IRNAS/PreciseXY/Photos/precisexy-v2-back.jpg

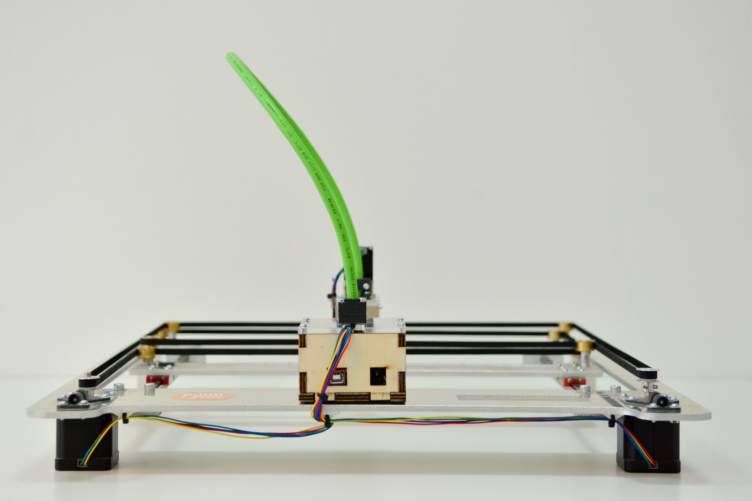
Photos/precisexy-v2-back.jpg
