IRNAS/PreciseXY/Photos/precisexy-v2-front.jpg

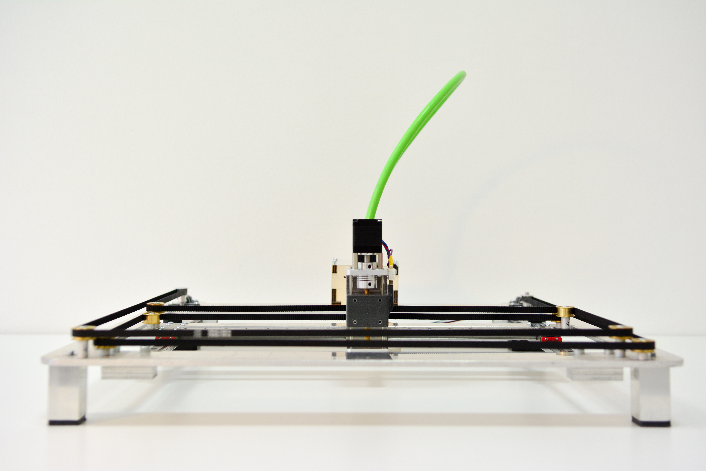
Photos/precisexy-v2-front.jpg
