IRNAS/PreciseXY/Photos/precisexy-v2-zaxis.jpg

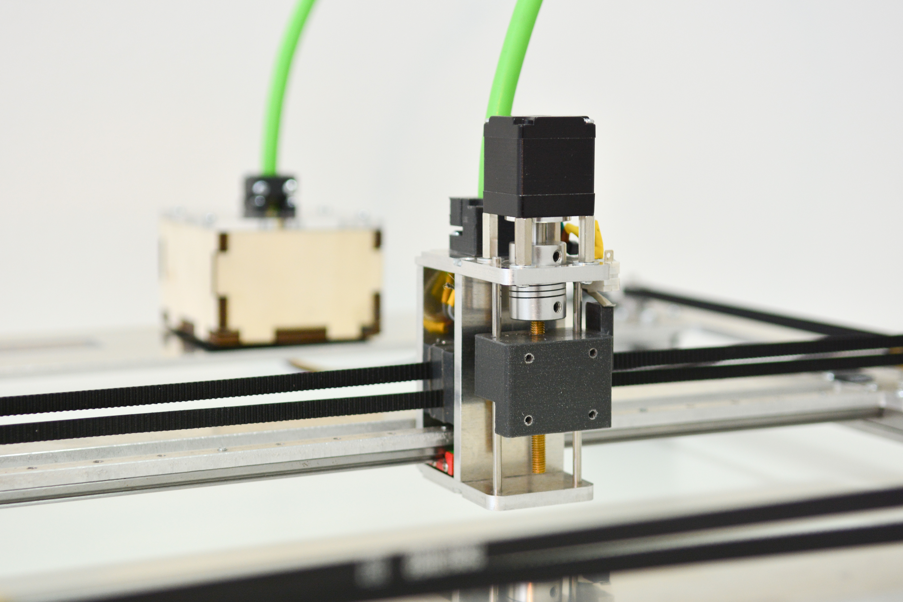
Photos/precisexy-v2-zaxis.jpg
