IRNAS/PreciseXY/Photos/precisexy-v2.jpg

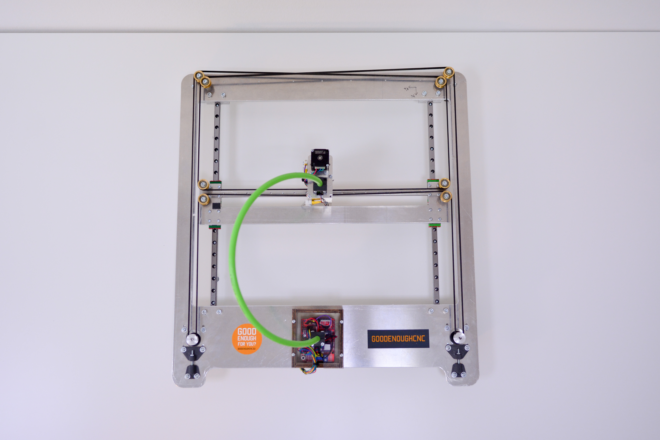
Photos/precisexy-v2.jpg
