IRNAS/PreciseXY/DXF/Assem - BOM.DXF

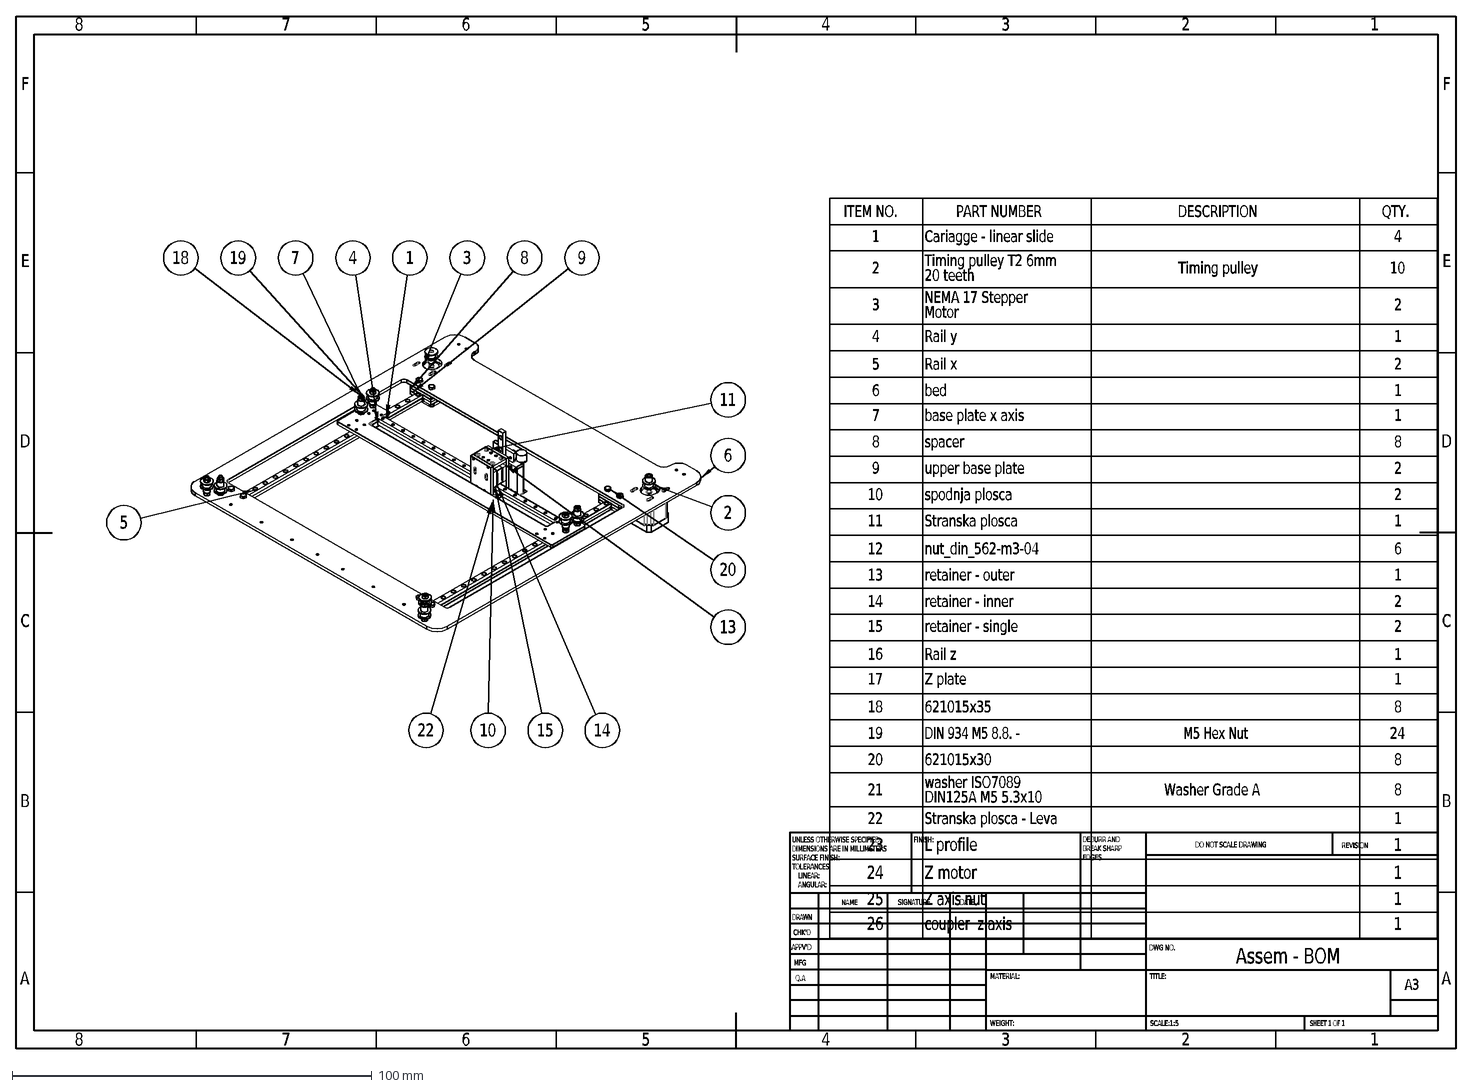
[picture p7: CAD file, 2015-09-21, last stored version]
DXF/Assem - BOM.DXF
8
7
A
B
2
3
4
5
6
1
E
D
C
F
DRAWN
CHK'D
APPV'D
MFG
Q.A
UNLESS OTHERWISE SPECIFIED:
DIMENSIONS ARE IN MILLIMETERS
SURFACE FINISH:
TOLERANCES:
LINEAR:
ANGULAR:
FINISH:
DEBURR AND
BREAK SHARP
EDGES
NAME
SIGNATURE
DATE
MATERIAL:
DO NOT SCALE DRAWING
REVISION
TITLE:
DWG NO.
SCALE:1:5
SHEET 1 OF 1
A3
WEIGHT:
Assem - BOM
ITEM NO.
PART NUMBER
DESCRIPTION
QTY.
Cariagge - linear slide
Timing pulley T2 6mm
20 teeth
Timing pulley
10
NEMA 17 Stepper
Motor
Rail y
Rail x
bed
base plate x axis
spacer
9
upper base plate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
