IRNAS/PreciseXY/Step/L profile.STEP

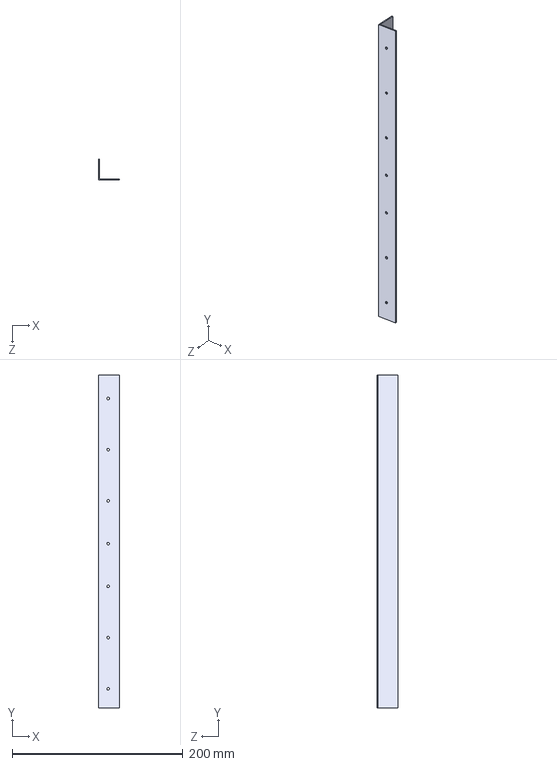
[picture p8: CAD file, 2015-09-21, last stored version]
Step/L profile.STEP
25.0 x 390.0 x 25.0 mm
