IRNAS/PreciseXY/Step/spodnja plosca.STEP

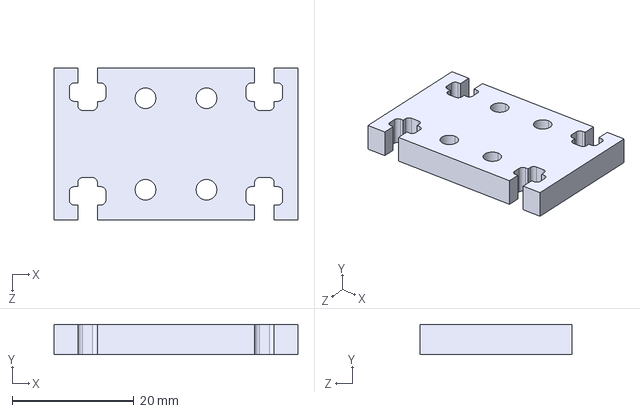
[picture p9: CAD file, 2015-09-21, last stored version]
Step/spodnja plosca.STEP
40.0 x 5.00 x 25.0 mm
