IRNAS/PreciseXY/Step/Timing pulley T2 6mm 20 teeth.STEP

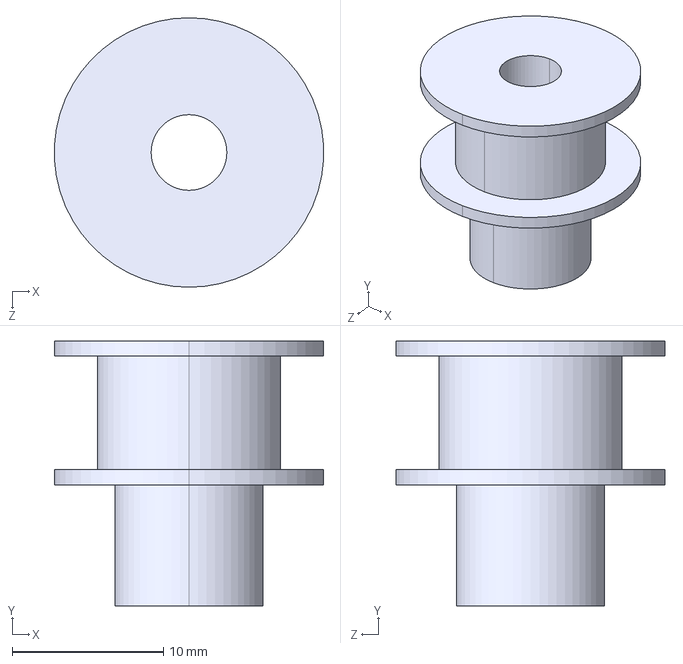
[picture p10: CAD file, 2015-09-21, last stored version]
Step/Timing pulley T2 6mm 20 teeth.STEP
17.8 x 17.5 x 17.8 mm
