IRNAS/PreciseXY/Step/base plate x axis.STEP

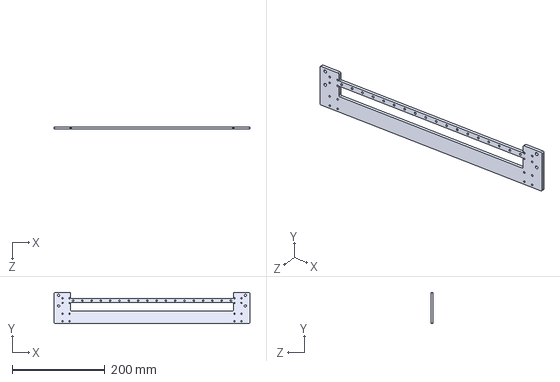
[picture p11: CAD file, 2015-09-21, last stored version]
Step/base plate x axis.STEP
422.0 x 66.8 x 5.00 mm
