IRNAS/PreciseXY/Step/Z plate.STEP

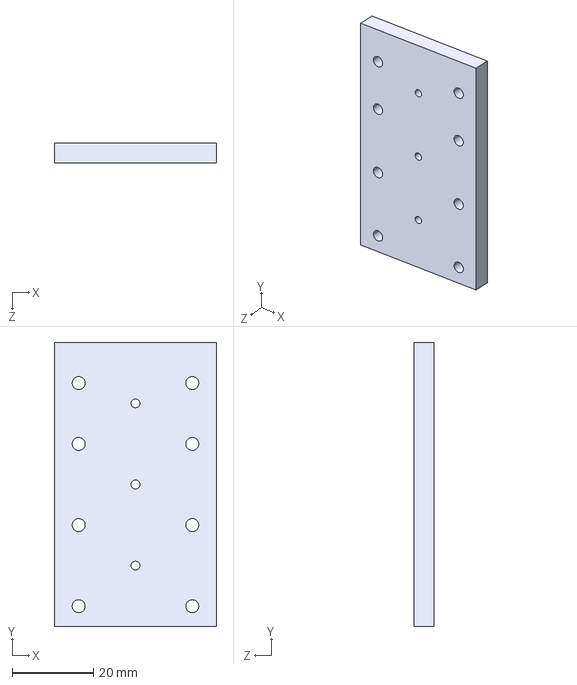
[picture p12: CAD file, 2015-09-21, last stored version]
Step/Z plate.STEP
40.0 x 70.0 x 5.00 mm
