IRNAS/PreciseXY/Step/coupler  z axis.STEP

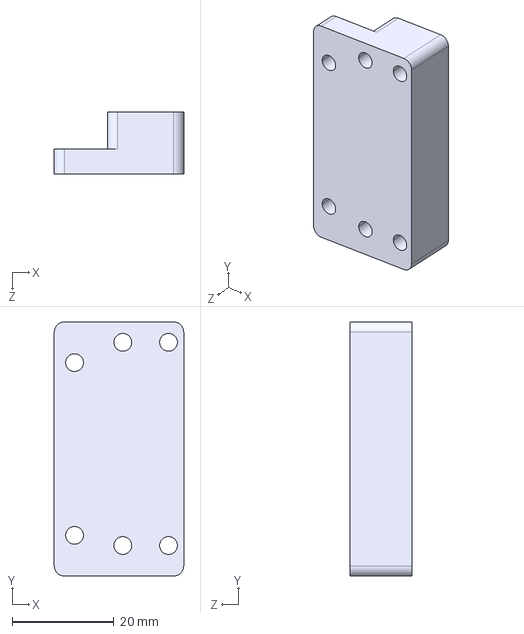
[picture p13: CAD file, 2015-09-21, last stored version]
Step/coupler z axis.STEP
25.5 x 50.0 x 12.3 mm
