IRNAS/PreciseXY/Step/Rail y.STEP

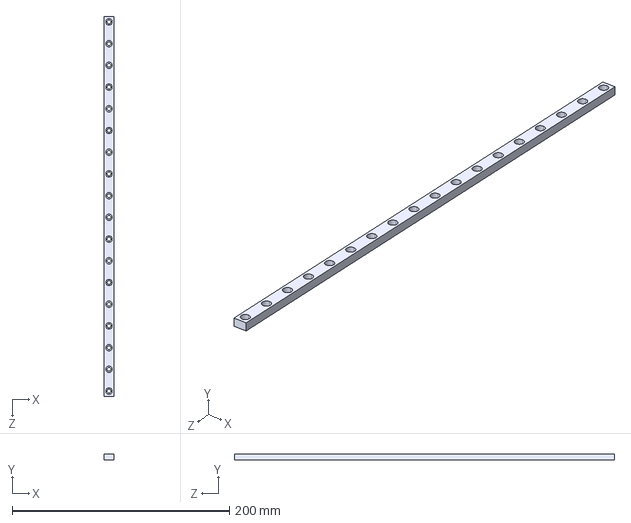
[picture p14: CAD file, 2015-09-21, last stored version]
Step/Rail y.STEP
9.00 x 5.50 x 350.0 mm
