IRNAS/PreciseXY/Step/Stranska plosca.STEP

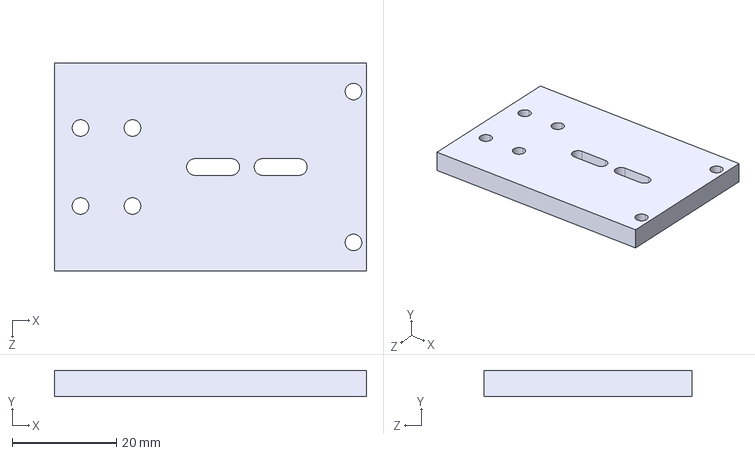
[picture p15: CAD file, 2015-09-21, last stored version]
Step/Stranska plosca.STEP
60.0 x 5.00 x 40.0 mm
