IRNAS/PreciseXY/Step/NEMA 17 Stepper Motor.STEP

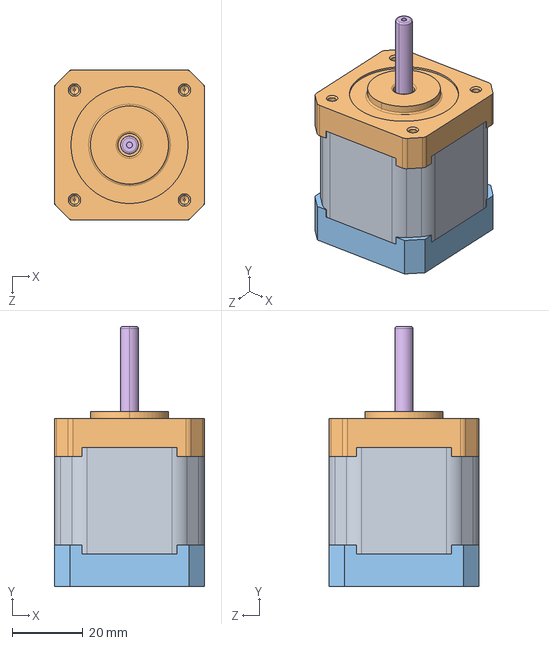
[picture p16: CAD file, 2015-09-21, last stored version]
Step/NEMA 17 Stepper Motor.STEP
42.3 x 73.3 x 42.3 mm
