IRNAS/PreciseXY/Step/retainer - outer.STEP

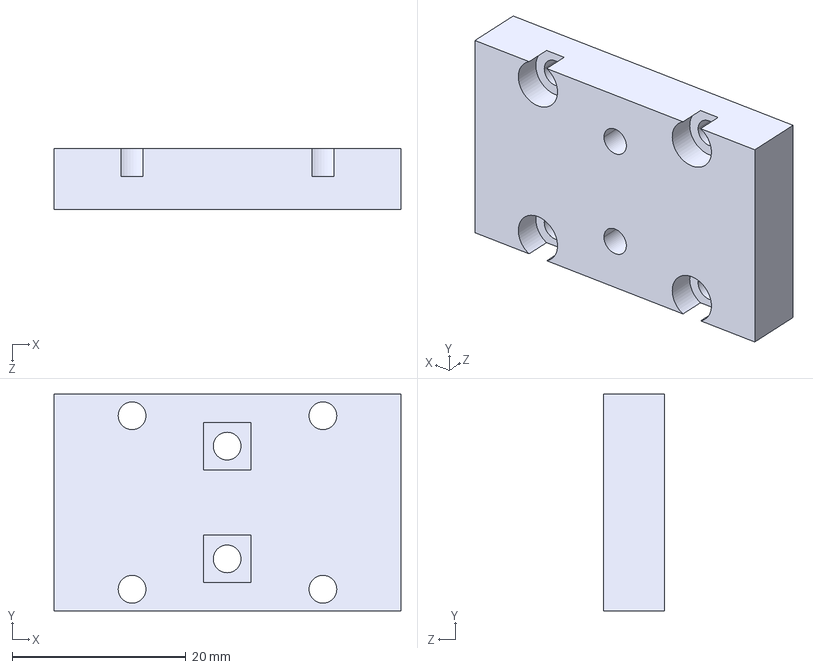
[picture p17: CAD file, 2015-09-21, last stored version]
Step/retainer - outer.STEP
40.0 x 25.0 x 7.00 mm
