IRNAS/PreciseXY/Step/retainer - single.STEP

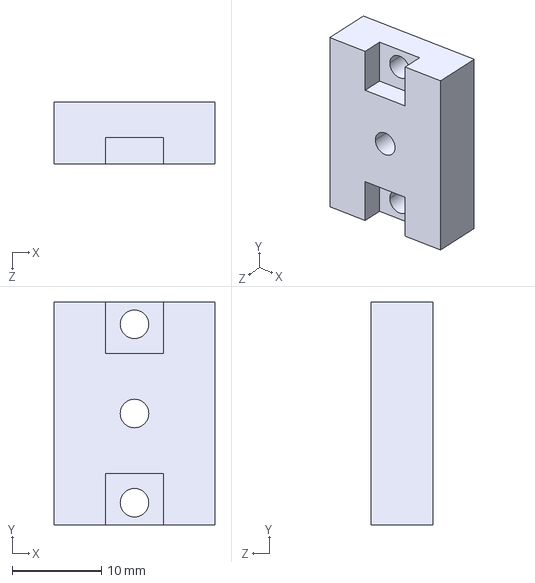
[picture p18: CAD file, 2015-09-21, last stored version]
Step/retainer - single.STEP
18.0 x 25.0 x 7.00 mm
