IRNAS/PreciseXY/Step/spacer.STEP

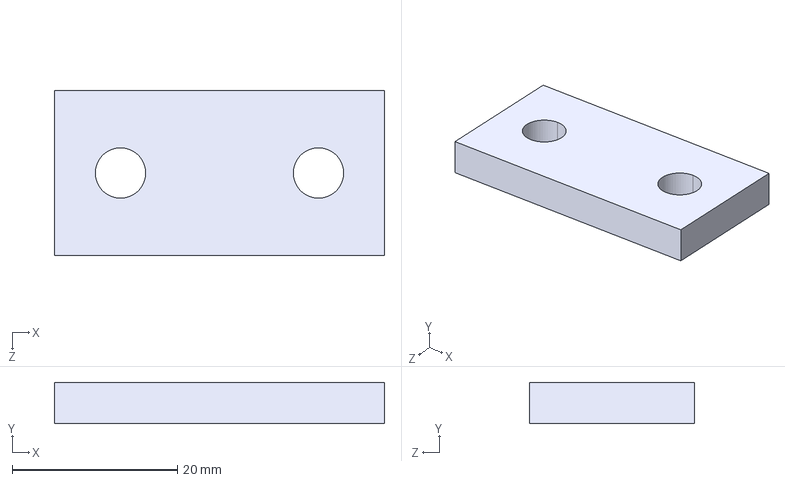
[picture p19: CAD file, 2015-09-21, last stored version]
Step/spacer.STEP
40.0 x 5.00 x 20.0 mm
