IRNAS/PreciseXY/Step/bed.STEP

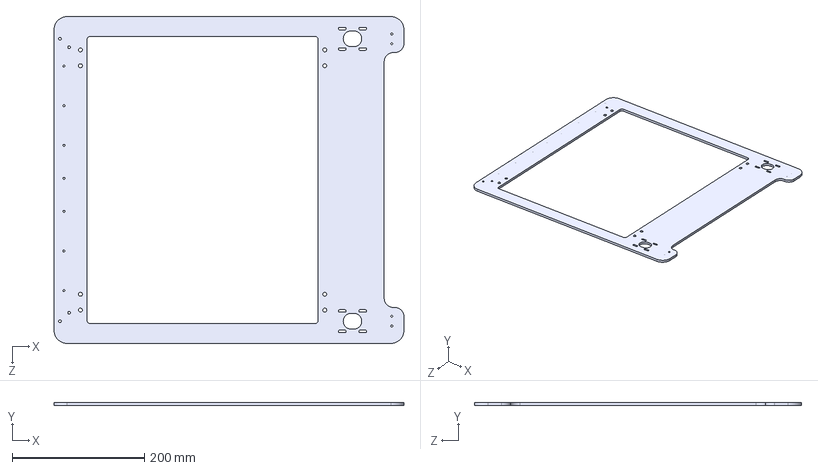
[picture p20: CAD file, 2015-09-21, last stored version]
Step/bed.STEP
530.0 x 5.00 x 495.0 mm
