IRNAS/PreciseXY/Step/upper base plate.STEP

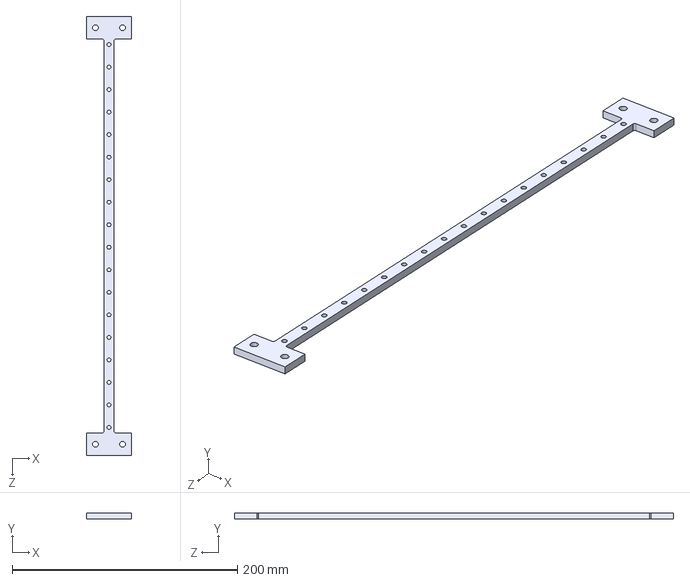
[picture p21: CAD file, 2015-09-21, last stored version]
Step/upper base plate.STEP
40.0 x 5.00 x 390.0 mm
