IRNAS/PreciseXY/Step/retainer - inner.STEP

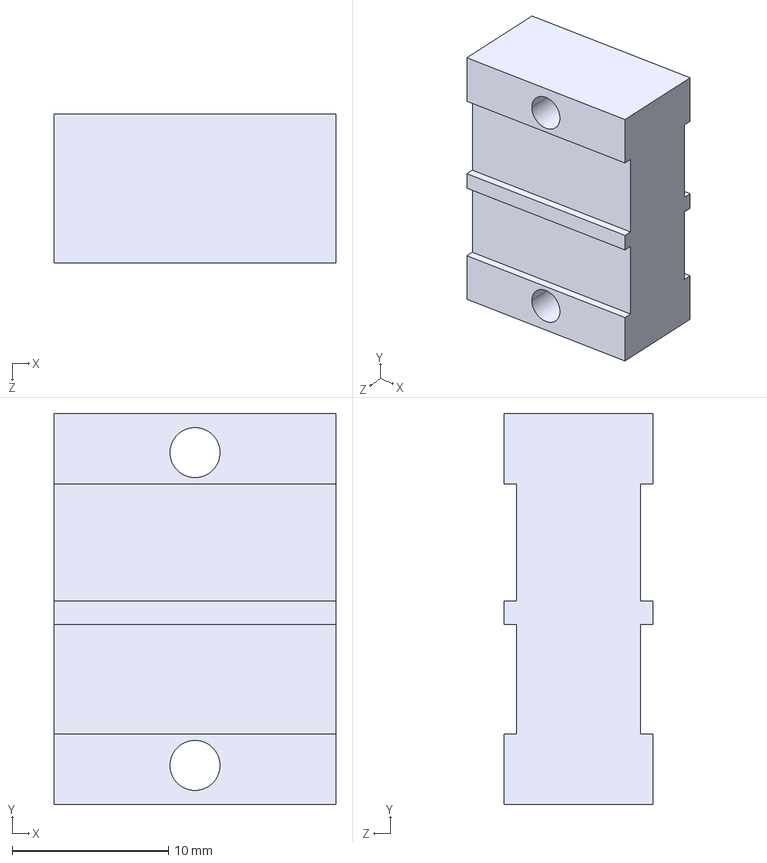
[picture p22: CAD file, 2015-09-21, last stored version]
Step/retainer - inner.STEP
18.0 x 25.0 x 9.50 mm
