IRNAS/PreciseXY/Step/Z motor.STEP

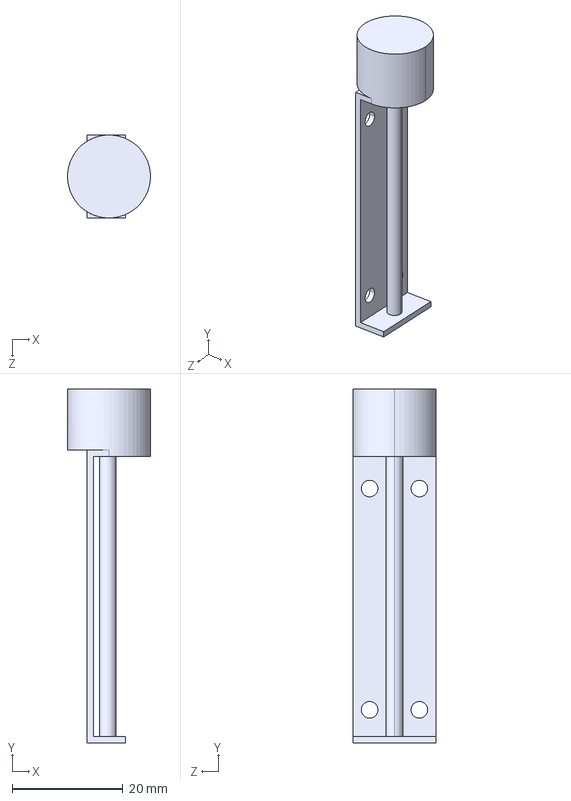
[picture p23: CAD file, 2015-09-21, last stored version]
Step/Z motor.STEP
15.0 x 64.0 x 15.0 mm
