IRNAS/PreciseXY/Step/Cariagge - linear slide.STEP

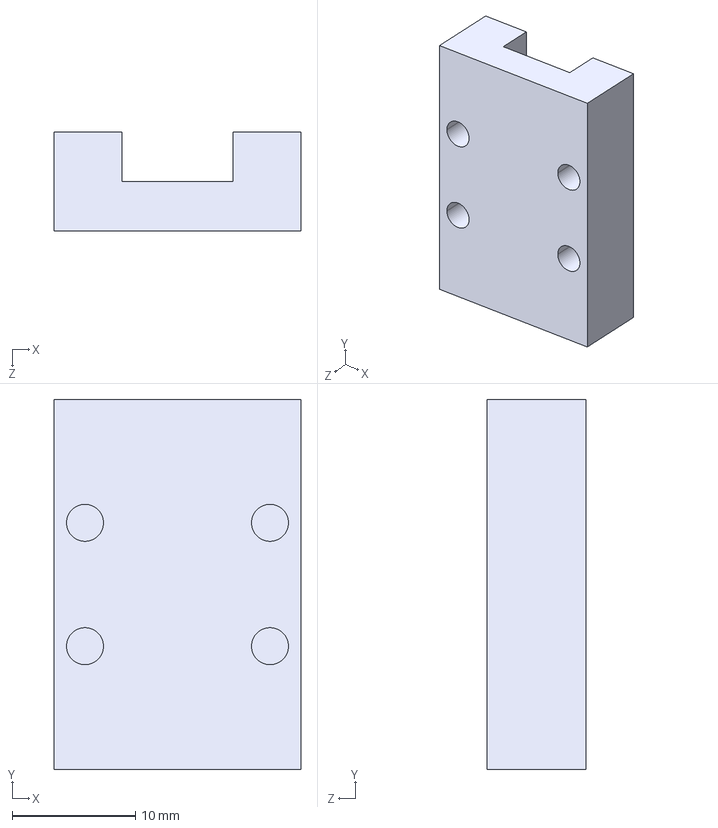
[picture p24: CAD file, 2015-09-21, last stored version]
Step/Cariagge - linear slide.STEP
20.0 x 30.0 x 8.00 mm
