IRNAS/PreciseXY/(list of files, cad)

Other CAD files:
Step/Rail x.STEP
Step/Stranska plosca - Leva.STEP
DXF/Bed.DXF
DXF/L profile.DXF
DXF/Stranska plosca - Leva.DXF
DXF/Stranska plosca.DXF
DXF/base plate x axis.DXF
DXF/spacer.DXF
DXF/spodnja plosca.DXF
DXF/upper base plate.DXF
Solidworks/Assem - BOM.SLDDRW
Solidworks/Bed.SLDDRW
Solidworks/L profile.SLDDRW
Solidworks/Stranska plosca - Leva.SLDDRW
Solidworks/Stranska plosca.SLDDRW
Solidworks/base plate x axis.SLDDRW
Solidworks/spacer.SLDDRW
Solidworks/spodnja plosca.SLDDRW
Solidworks/upper base plate.SLDDRW
Step/621015x35.STEP
Step/DIN 934 M5 8.8. -.STEP
Step/Z axis nut.STEP
