IRNAS/PreciseXY/PDF/Assem - BOM.PDF

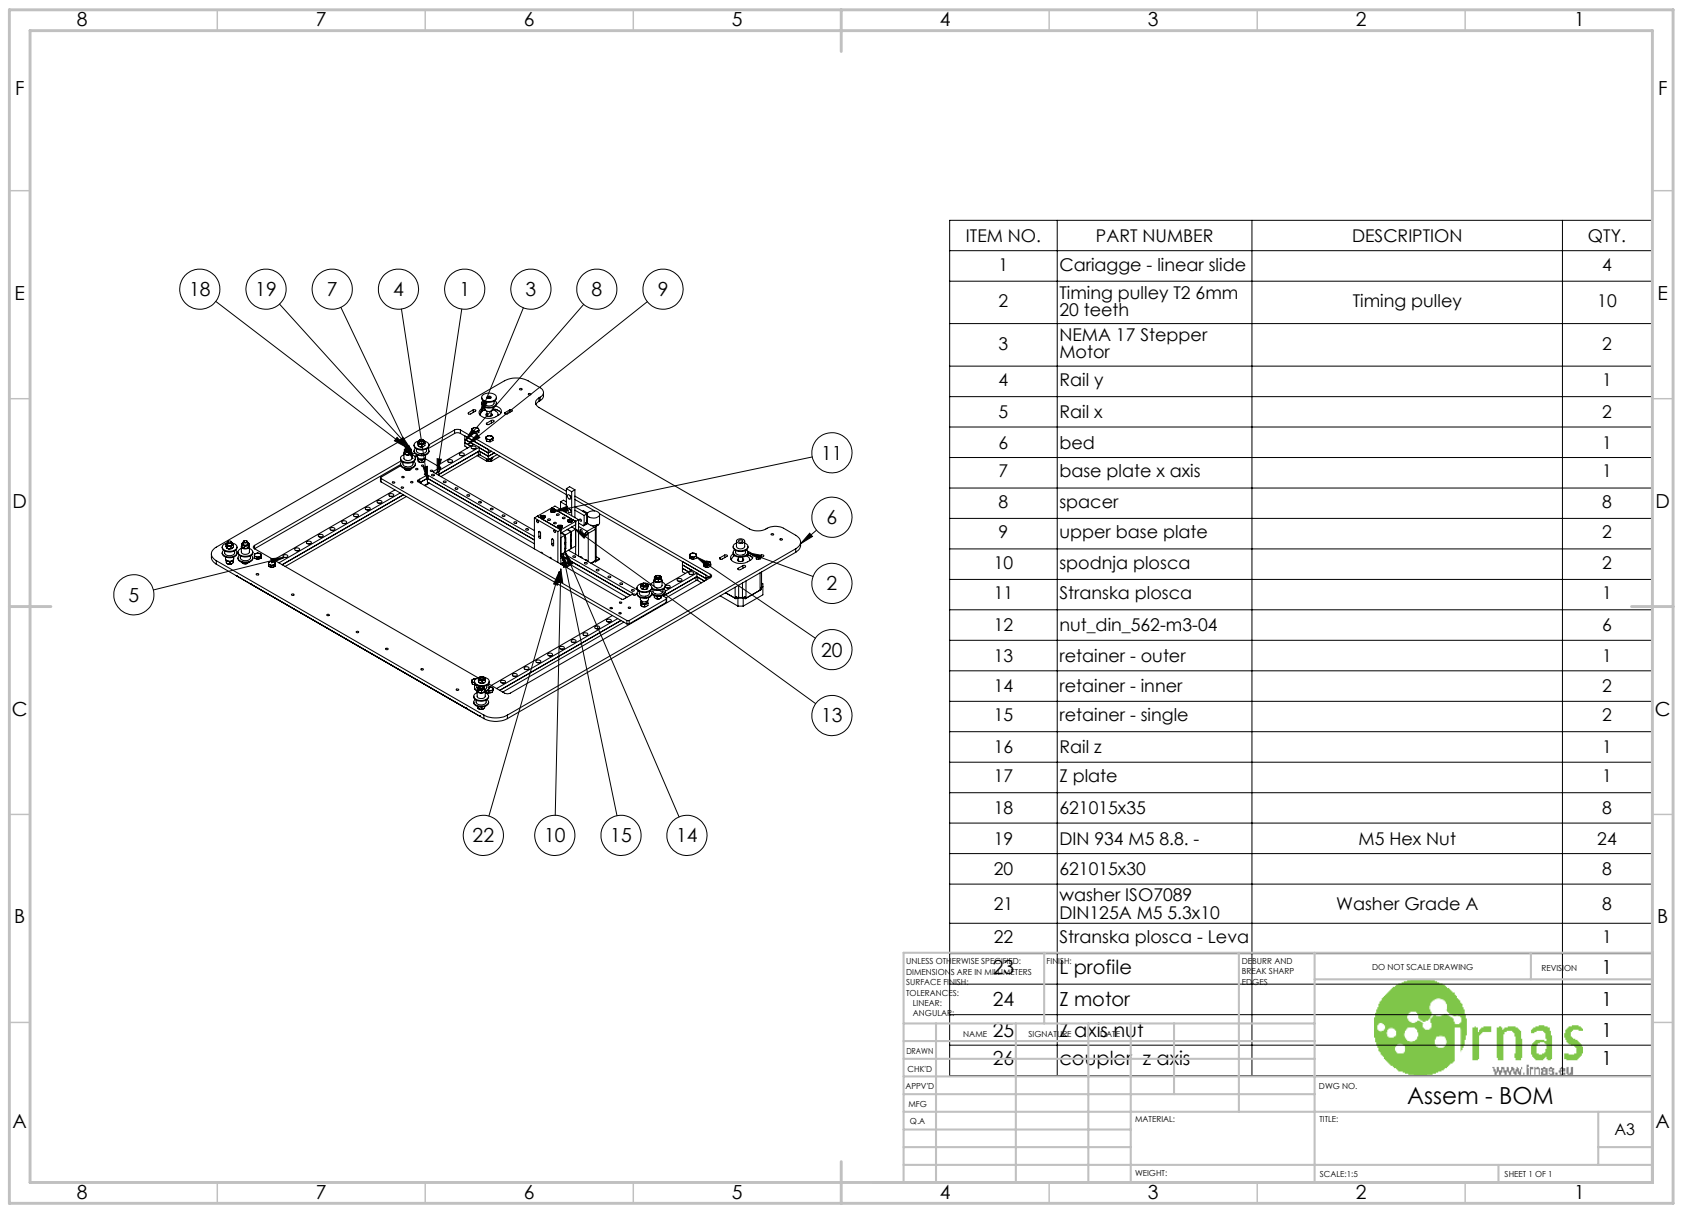
[picture p25: page 1]
SCALE:1:5; SHEET 1 OF 1

ITEM NO. | PART NUMBER | DESCRIPTION | QTY.
1 | Cariagge - linear slide | | 4
2 | Timing pulley T2 6mm 20 teeth | Timing pulley | 10
3 | NEMA 17 Stepper Motor | | 2
4 | Rail y | | 1
5 | Rail x | | 2
6 | bed | | 1
7 | base plate x axis | | 1
8 | spacer | | 8
9 | upper base plate | | 2
10 | spodnja plosca | | 2
11 | Stranska plosca | | 1
12 | nut_din_562-m3-04 | | 6
13 | retainer - outer | | 1
14 | retainer - inner | | 2
15 | retainer - single | | 2
16 | Rail z | | 1
17 | Z plate | | 1
18 | 621015x35 | | 8
19 | DIN 934 M5 8.8. - | M5 Hex Nut | 24
20 | 621015x30 | | 8
21 | washer ISO7089 DIN125A M5 5.3x10 | Washer Grade A | 8
22 | Stranska plosca - Leva | | 1

UNLESS OTHERWISE SPECIFIED: DIMENSIONS ARE IN MILLIMETERS SURFACE FINISH: TOLERANCES: LINEAR: ANGULAR: | 23 | FINISH: | L profile | DEBURR AND BREAK SHARP EDGES | DO NOT SCALE DRAWING | REVISION | 1

24 | | Z motor | | | | 1
26 | coupler | | z axis | | | | 1

25 NAME | SIGNATURE | Z axis nut | DATE

DRAWN
CHK'D
APPV'D | | | | | | DWG NO. Assem - BOM
MFG
Q.A | | | MATERIAL: | TITLE: | A3
