IRNAS/PreciseXY/PDF/base plate x axis.PDF

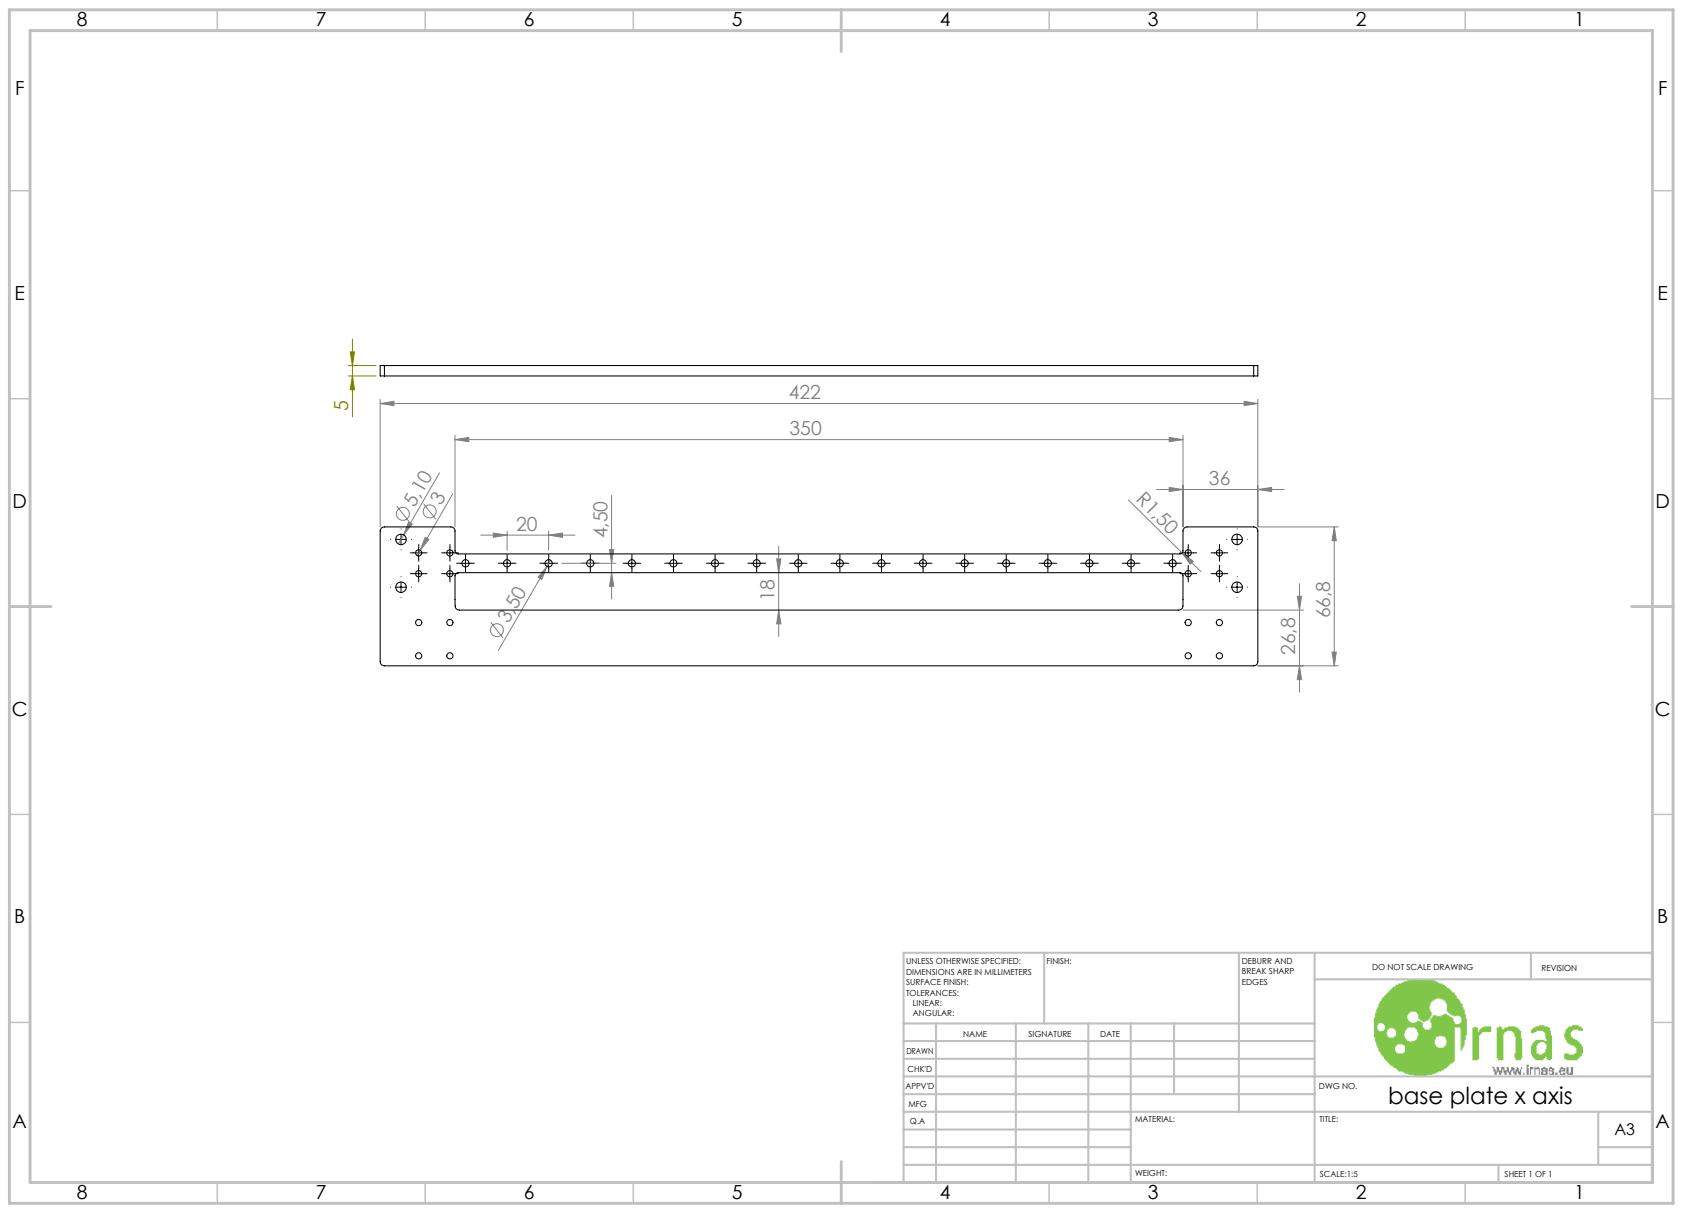
[picture p26: page 1]
FINISH:; DEBURR AND; BREAK SHARP; DO NOT SCALE DRAWING; REVISION; SCALE:1:5; SHEET 1 OF 1

UNLESS OTHERWISE SPECIFIED:
DIMENSIONS ARE IN MILLIMETERS
SURFACE FINISH:
TOLERANCES:
LINEAR:
ANGULAR:

NAME | SIGNATURE | DATE

DRAWN
CHK'D
APPV'D | | | | | | | DWG NO. base plate x axis
MFG
Q.A | | | | MATERIAL: | TITLE: | A3
