IRNAS/PreciseXY/PDF/Bed.PDF

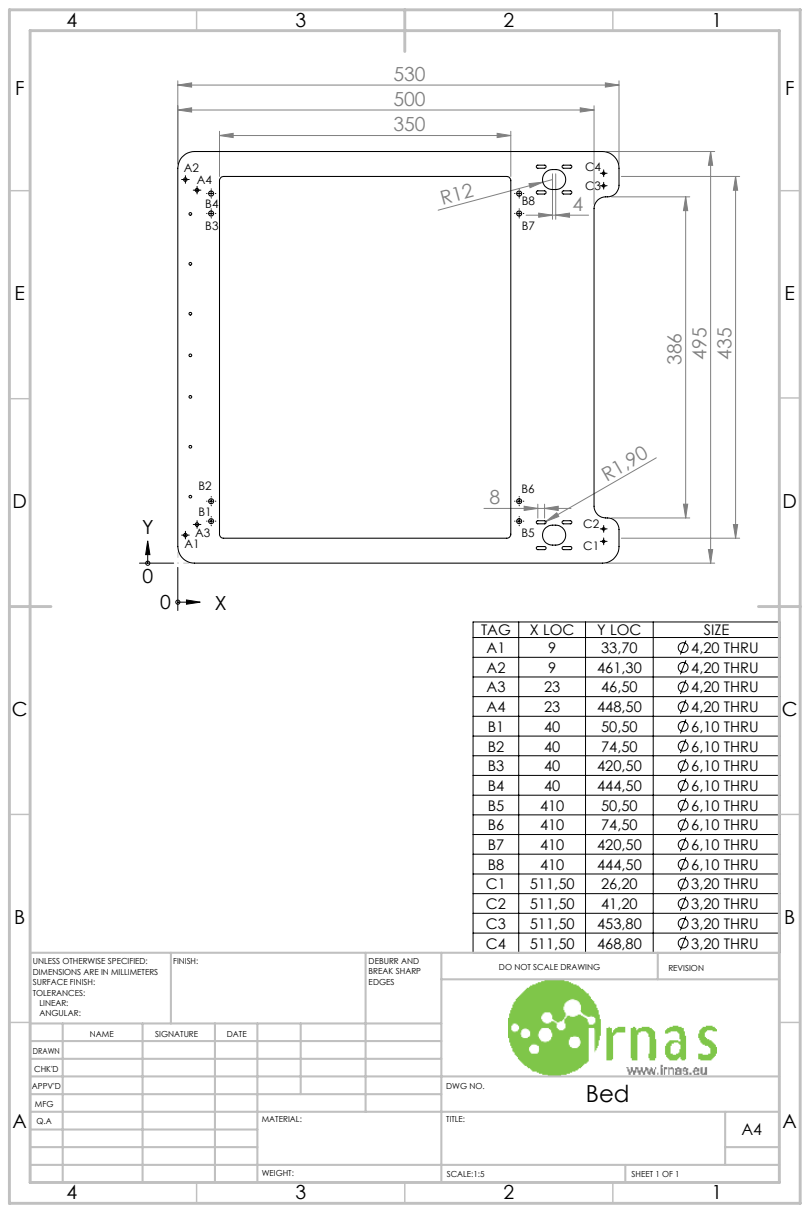
[picture p27: page 1]
6,10 THRU; SCALE:1:5; SHEET 1 OF 1

TAG | X LOC | Y LOC | SIZE
A1 | 9 | 33,70 | 4,20 THRU
A2 | 9 | 461,30 | 4,20 THRU
A3 | 23 | 46,50 | 4,20 THRU
A4 | 23 | 448,50 | 4,20 THRU
B1 | 40 | 50,50 | 6,10 THRU
B2 | 40 | 74,50 | 6,10 THRU
B3 | 40 | 420,50 | 6,10 THRU
B4 | 40 | 444,50 | 6,10 THRU
B5 | 410 | 50,50 | 6,10 THRU

B7 | 410 | 420,50 | 6,10 THRU
B8 | 410 | 444,50 | 6,10 THRU
C1 | 511,50 | 26,20 | 3,20 THRU
C2 | 511,50 | 41,20 | 3,20 THRU
C3 | 511,50 | 453,80 | 3,20 THRU
C4 | 511,50 | 468,80 | 3,20 THRU

UNLESS OTHERWISE SPECIFIED: DIMENSIONS ARE IN MILLIMETERS SURFACE FINISH: TOLERANCES: LINEAR: ANGULAR: | FINISH: | DEBURR AND BREAK SHARP EDGES | DO NOT SCALE DRAWING | REVISION

NAME | SIGNATURE | DATE

DRAWN
CHK'D
APPV'D | | | | | | | Bed DWG NO.

MFG
Q.A | | | | MATERIAL: | TITLE: | A4
