IRNAS/PreciseXY/PDF/spacer.PDF

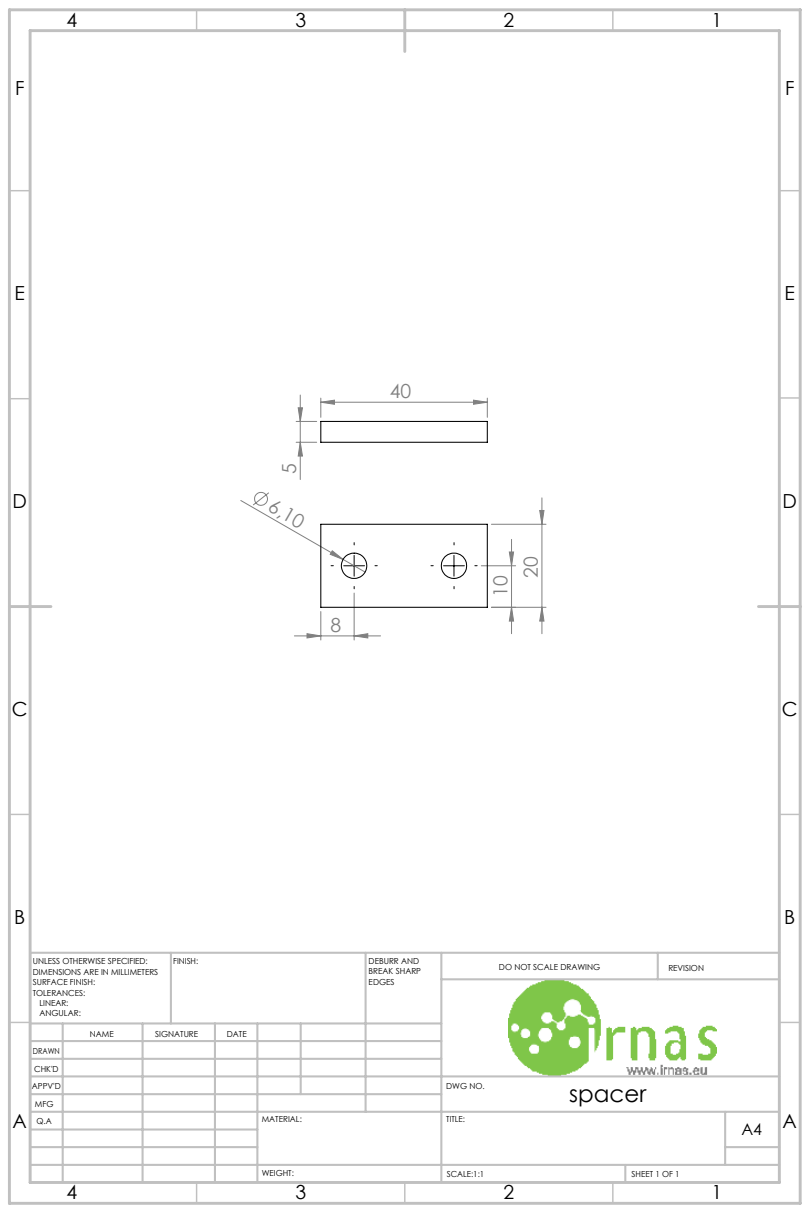
[picture p28: page 1]
FINISH:; DEBURR AND; BREAK SHARP; DO NOT SCALE DRAWING; REVISION; SCALE:1:1; SHEET 1 OF 1

UNLESS OTHERWISE SPECIFIED:
DIMENSIONS ARE IN MILLIMETERS
SURFACE FINISH:
TOLERANCES:
LINEAR:
ANGULAR:

NAME | SIGNATURE | DATE

DRAWN
CHK'D
APPV'D | | | | | | | spacer DWG NO.

MFG
Q.A | | | | MATERIAL: | TITLE: | A4
